as3ert/apple-keyboard-ii/layout/Layout.png

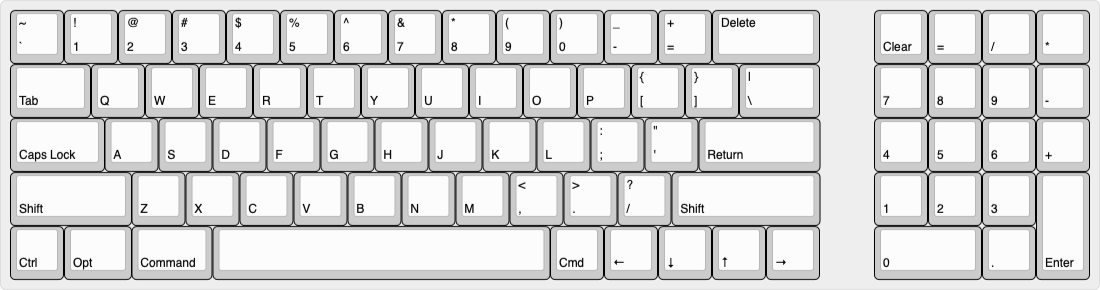
layout/Layout.png
