as3ert/apple-keyboard-ii/pcb/BOM.xlsx

No. | Quantity | Comment | Designator | Footprint | Manufacturer Part | Manufacturer
1 | 2 | 22pF | C1,C2 | C0805 | 0805CG220J500NT | FH(风华) | 优信电子 | 50
2 | 4 | 100nF | C3,C4,C5,C6 | C0805 | 0805B104J500NT | FH(风华) | 优信电子 | 50
3 | 1 | 10uF | C7 | C0805 | CL21A106KBYQNNE | SAMSUNG(三星) | 优信电子 | 50
4 | 2 | 1uF | C8,C9 | C0805 | CL21B105KBFNNNE | SAMSUNG(三星) | 优信电子 | 50
5 | 1 | PRTR5V0U2X-N | D2 | SOT-143_L2.9-W1.3-P1.92-LS2.3-BL | PRTR5V0U2X-N | Bourne Semicon (Shenzhen) | 优信电子 | 5
6 | 2 | 10kΩ | R1,R2 | R0805 | RC0805DR-0710KL | YAGEO(国巨) | 优信电子 | 100
7 | 2 | 22Ω | R3,R4 | R0805 | RC0805FR-0722RL | YAGEO(国巨) | 优信电子 | 100
8 | 2 | 5.1kΩ | R5,R6 | R0805 | RC0805FR-075K1L | YAGEO(国巨) | 优信电子 | 100
9 | 1 | ATMEGA32U4-AU | U1 | QFP-44_L10.0-W10.0-P0.80-LS13.2-BL | ATMEGA32U4-AU | MICROCHIP(美国微芯) | 优信电子 | 2
10 | 1 | TYPE-C-31-M-12 | USBC1 | USB-C_SMD-TYPE-C-31-M-12 | TYPE-C-31-M-12 | 韩国韩荣 | 原芯商城 | 5
11 | 1 | 16MHz | X1 | OSC-SMD_2P-L5.0-W3.2 | XSHEELNANF-16MHZ | TAITIEN(泰艺电子) | 原芯商城 | 4
12 | 2 | FPC05028-43200 | FPC1 | FPC-SMD_FPC05028-43200 | FPC05028-43200 | ATOM(爱特姆) | 原芯商城 | 4
13 | 80 |  |  |  | SOD4002-SH | 乐山 LRC | 原芯商城 | 100
14 | 80 |  |  |  | PG1511 | 凯华kailh | 御械数码外设 | 110
15 | 1 | Switch3x4x2 | KEY1 | SW-SMD_L4.0-W2.9-LS5.0 | HX 3x4x2-2P-2.5N | 国产
