as3ert/apple-keyboard-ii/model/knob.stl

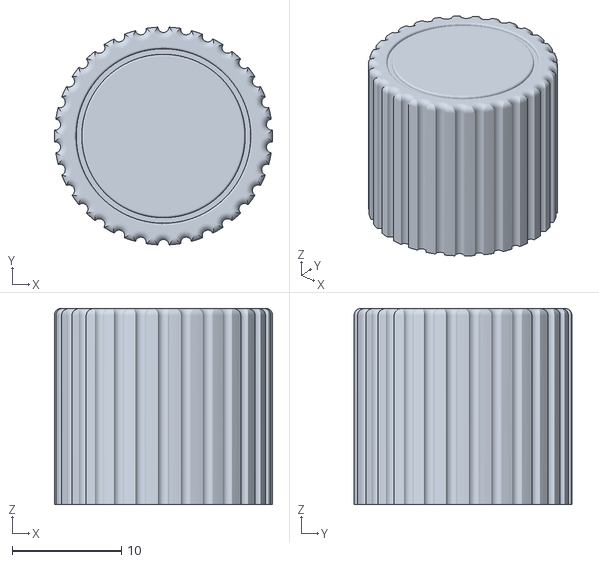
[picture p2: CAD file, 2025-10-27]
model/knob.stl
20.0 x 20.0 x 18.0
