as3ert/apple-keyboard-ii/model/USB Long.stl

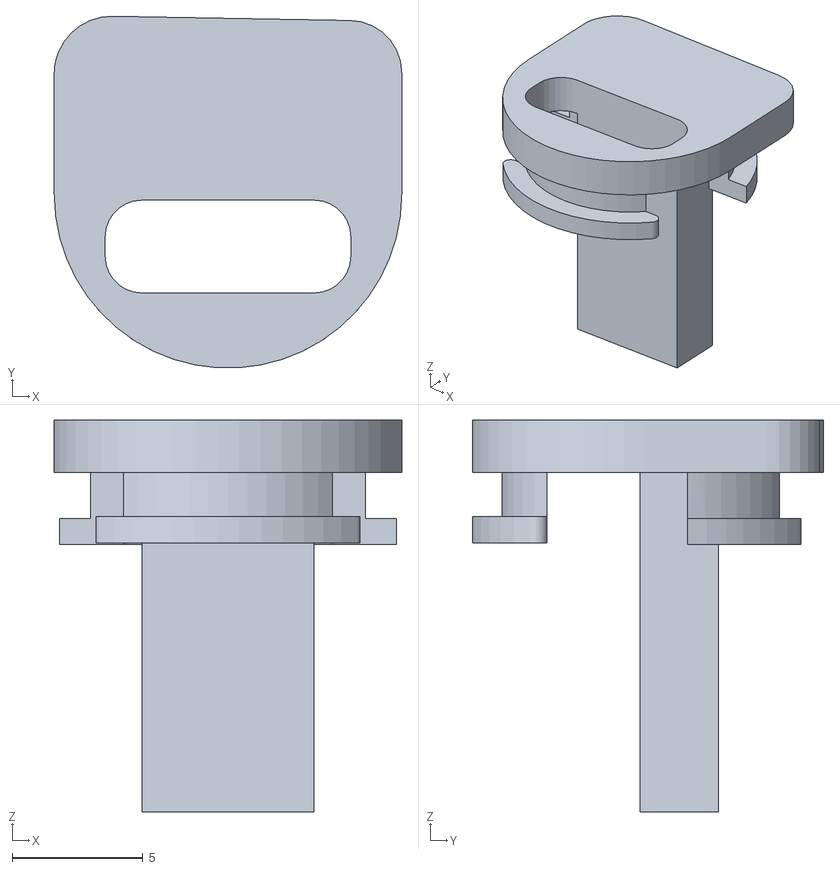
[picture p3: CAD file, 2025-10-27]
model/USB Long.stl
13.3 x 13.4 x 15.0
