as3ert/apple-keyboard-ii/model/USB-fill-Fusion.stl

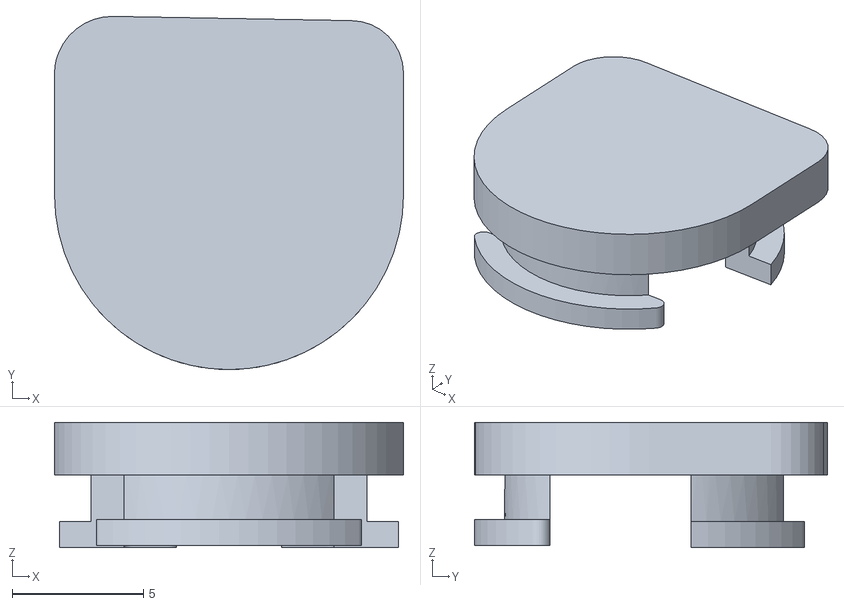
[picture p4: CAD file, 2025-10-27]
model/USB-fill-Fusion.stl
13.3 x 13.5 x 4.77
