as3ert/apple-keyboard-ii/model/plate.dxf

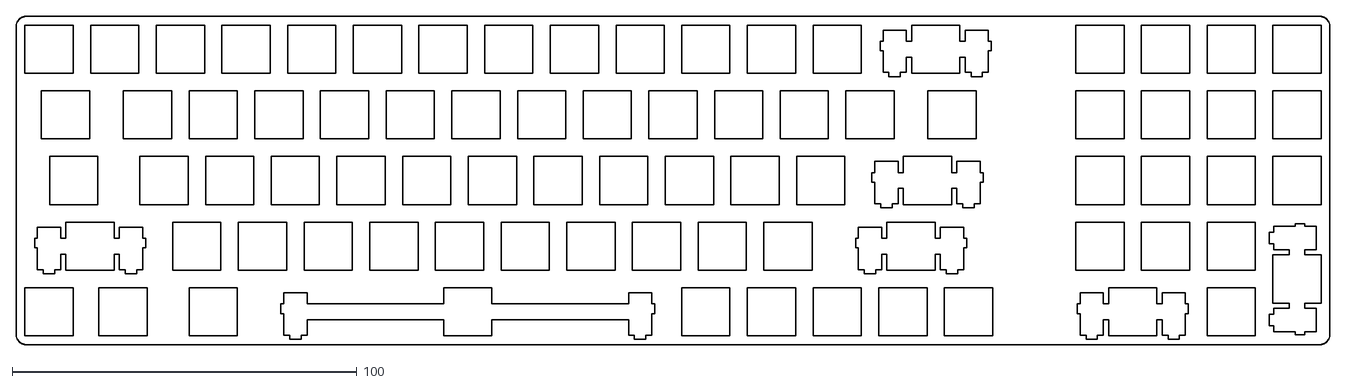
[picture p5: CAD file, 2025-10-27]
model/plate.dxf
381.0 x 95.3
