as3ert/apple-keyboard-ii/model/housing.stl

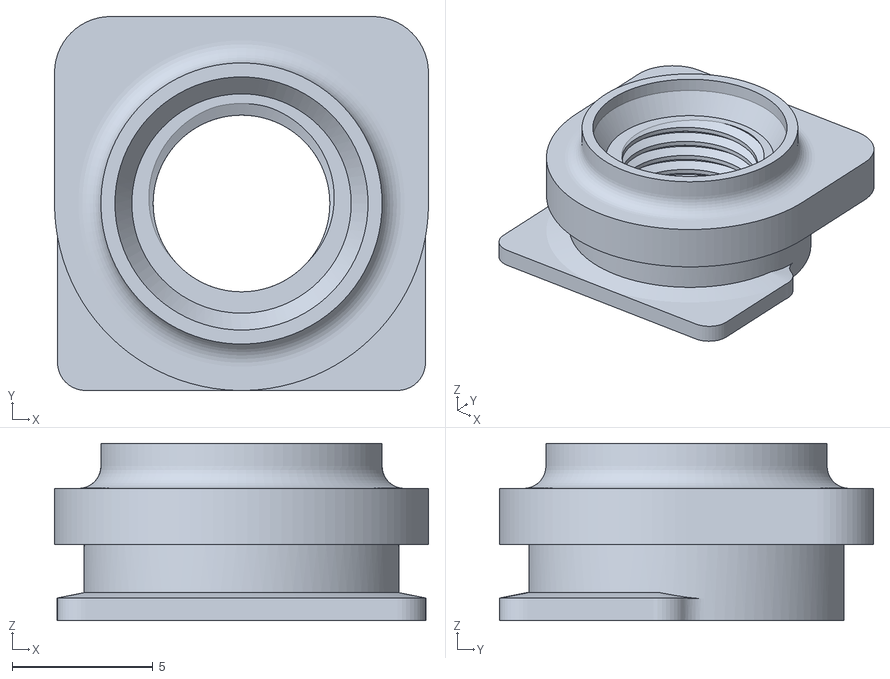
[picture p6: CAD file, 2025-10-27]
model/housing.stl
13.3 x 13.3 x 6.30
