as3ert/apple-keyboard-ii/(list of files, cad)

Other CAD files:
model/USB.FCStd
model/USB-fill.FCStd
model/USB.stl
