as3ert/apple-keyboard-ii/(list of files, drawings)

Other design files:
pcb/main-pcb.dsn
