as3ert/apple-keyboard-ii/(commit log)

2025-10-27 Update AKII
    [BOM.xlsx, USB Long.stl, USB-fill-Fusion.stl, USB-fill.FCStd, USB.FCStd, USB.stl, housing.stl, knob.stl]
2026-06-21 Track firmware/tools/tests/handoff doc; update daily uf2 (left-hand media + Windows layer, md5 14cb95d7)
